mfxuus/music-x-flute/materials/descriptions.docx

5V 10A Power Supply: https://www.amazon.com/dp/B0852HL336

SG90 9G Micro Servo Motor: https://www.amazon.com/dp/B07L2SF3R4

PCA9685 16 Channel 12 Bit PWM Servo Driver: https://www.amazon.com/dp/B014KTSMLA

Caps: https://www.amazon.com/dp/B081XTKCLH

Elastic Band: https://www.amazon.com/dp/B09BQZB98K

Hook and Loop Tape: https://www.amazon.com/dp/B08KP577YY

… along with Raspberry Pi 4 Model B, SD Card, Power Cord for Pi, and connection wires I already had.

Code repo (private repo, for now):

https://github.com/mfxuus/music-x

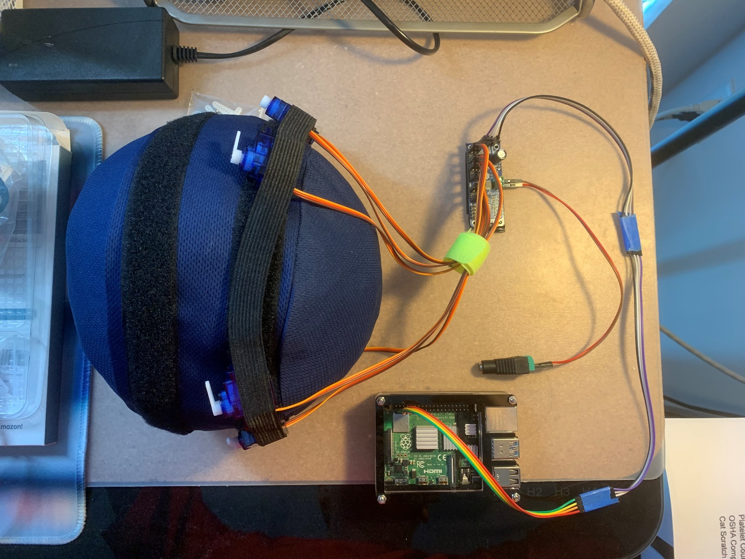
[picture p2: figure]
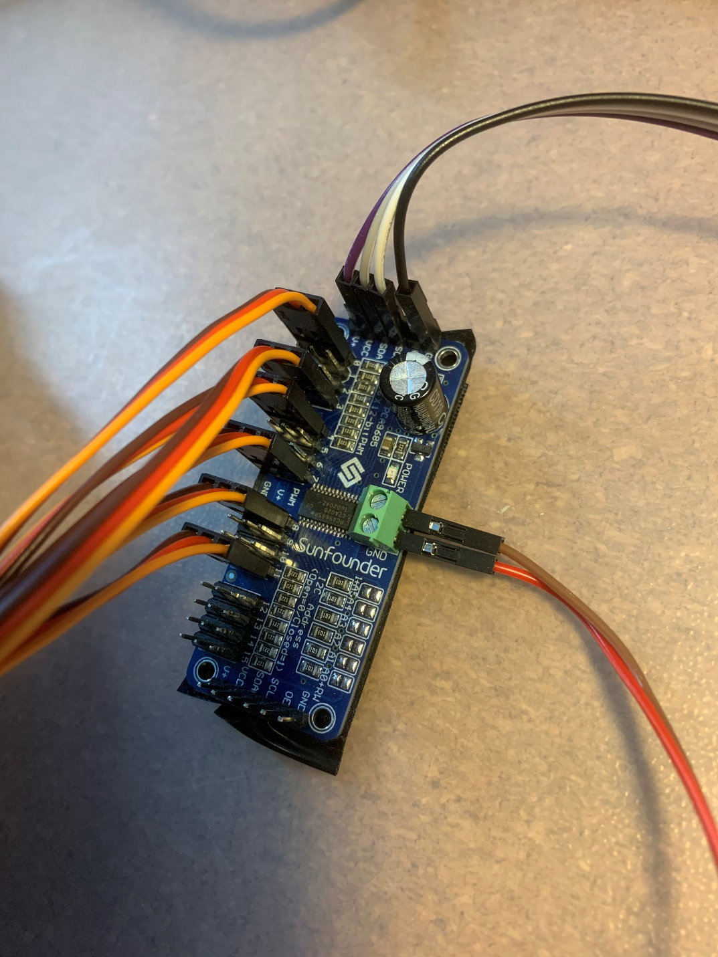
[picture p3: figure]
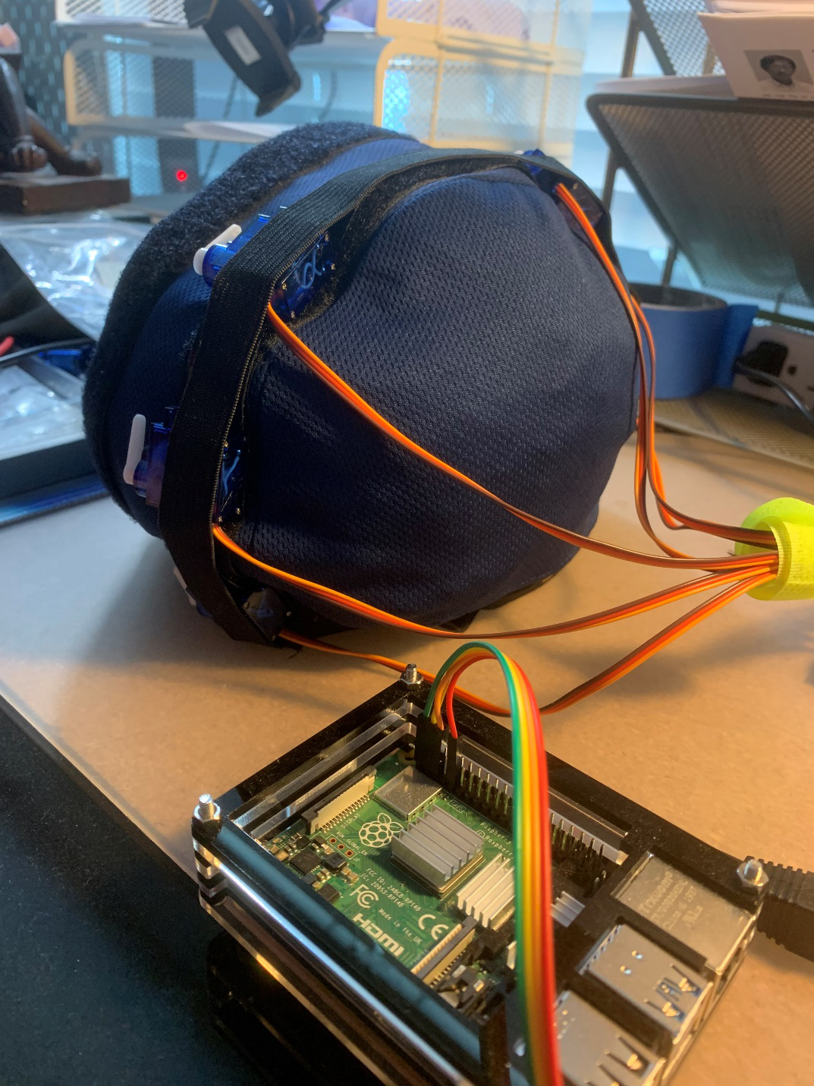
[picture p4: figure]
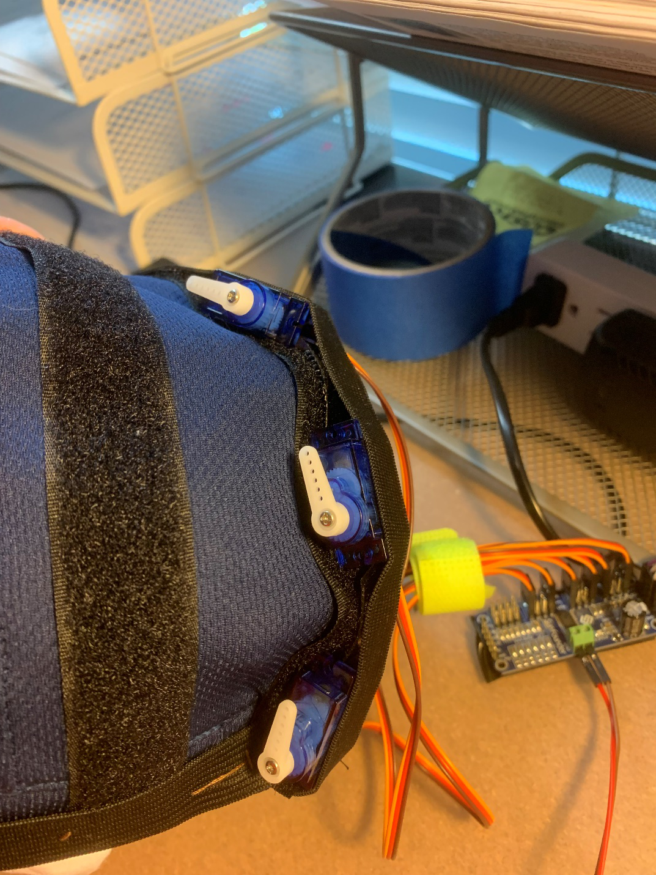
[picture p5: figure]
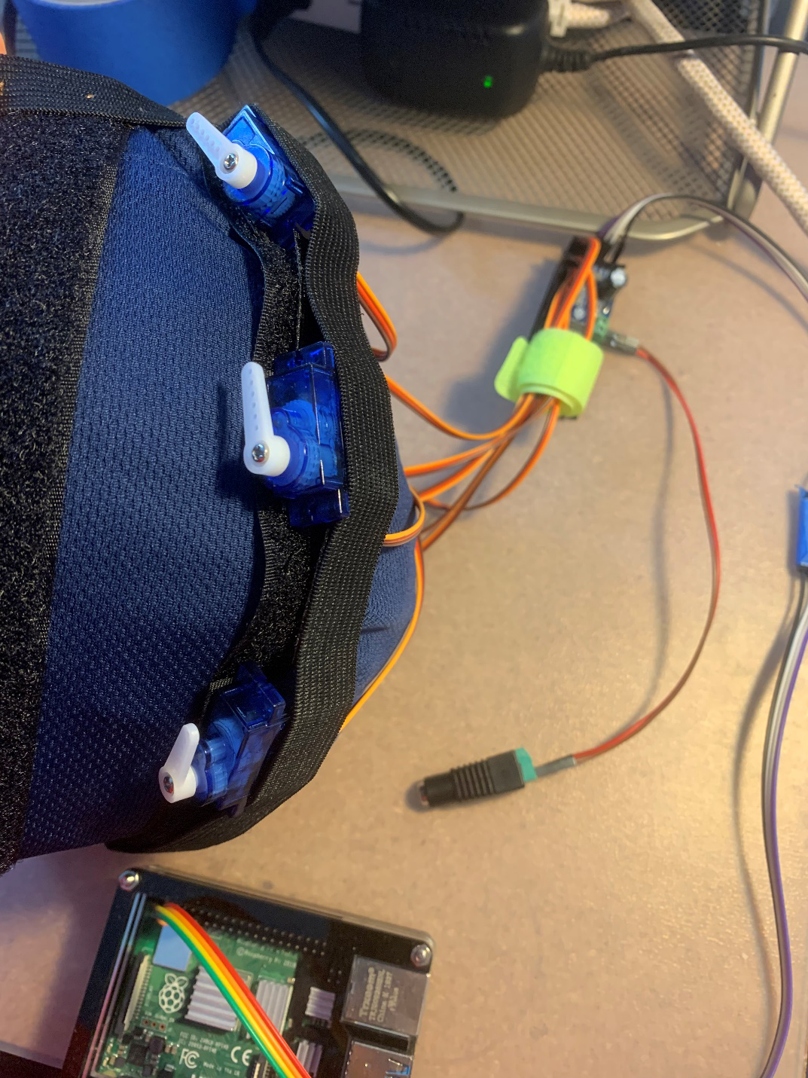
[picture p6: figure]
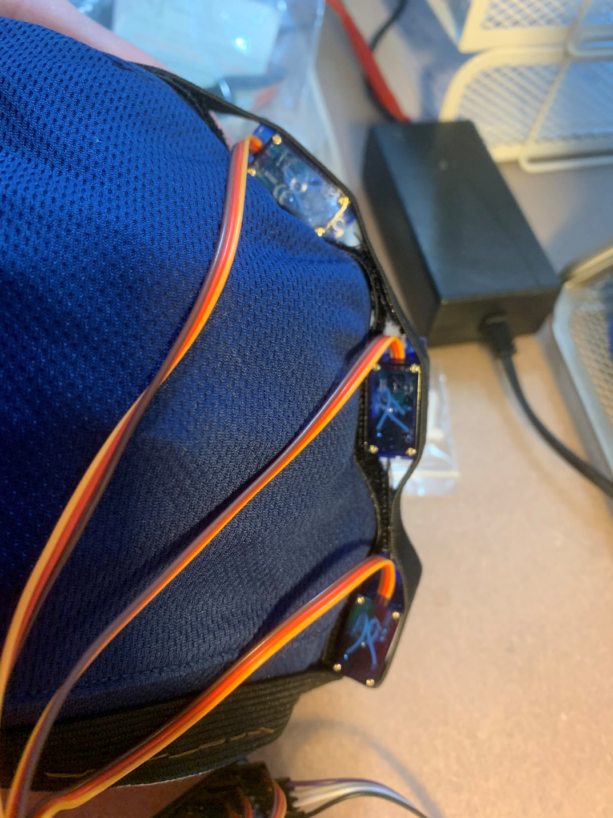
[picture p7: figure]
