mfxuus/music-x-flute/materials/Assembly_Guide.pdf

# Unibody C-Ring Prototype Assembly Guide

Prototype V4.3

- "Body" refers to the flute body part, with six holes, printed by MJF.

o

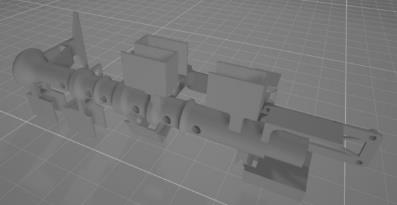
[picture p8: figure]

- In this guide, ordinals start with zero. 0th, 1st, etc.
- Here are the lab-printed parts:
C-Ring × 6 | NanoClip | sensorBox adaptor
sensorBox
grate

sensorBox muter sensorBox
ring
1. Principles:

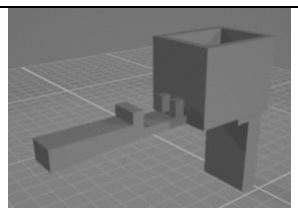
[picture p9: figure]

a. When using hot glue, keep in mind that this is a modular, detachable design. You should be able to remove whatever hot glue there is and replace parts. i.e., don’t much too much hot glue and avoid nooks and crannies.
2. Install a PCA9685 onto Body with nuts and bolts.

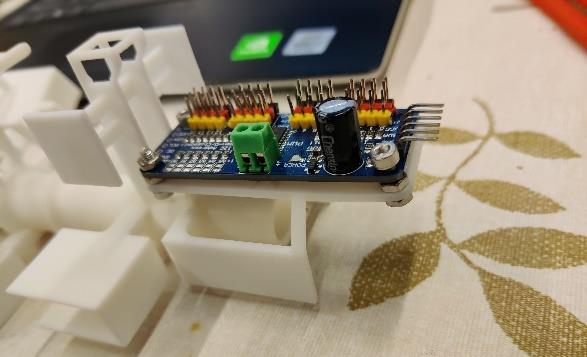
[picture p10: figure]

3. Stick pieces of the bronze tape onto Body.

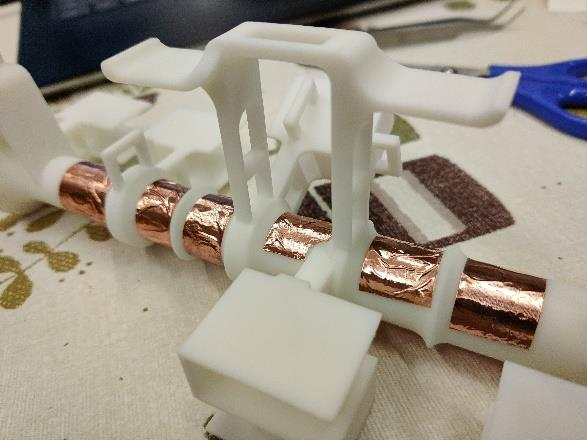
[picture p11: figure]

a. We will call one segment of tape “a tape”.
b. Each tape should enclose both the top (hole area) and the bottom of Body as a “C” shape. The “C” should face against the servo shells, so that you have enough space for tools to move. (It’s ok for a tape to be too long.)

c. Always cut out the left and right borders (making the segment less wide), since these borders are less sticky. (They are usually visibly worn out.)
d. The tapes should not cover areas with too much curvature. In those cases, cut out some tape to avoid edges and curvatures.
e. Press down on every corner of the tapes to ensure contact.
4. Use a box cutter (美工刀) to carve out the holes.

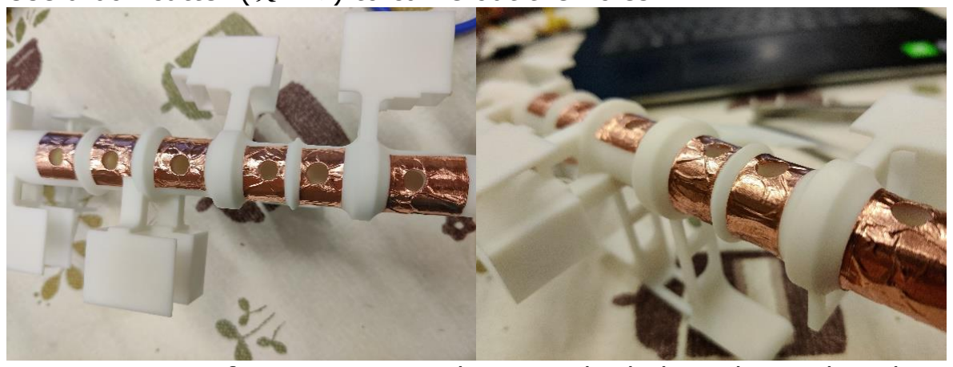
[picture p12: figure]

a. Use your fingers to press down on the holes. This makes the outline of the holes more visible.
b. It’s ok to have some bronze left in the hole. Curve those bronze skirts inward and press them against the inside of the holes. Never cut away too much, otherwise the capacitor sensor may miss the player’s finger.
c. I usually make six cuts forming a hexagon. This makes the process very fast.
5. Did you know? Bronze is bad for your health. Wash your hands NOW!
6. Install an Arduino Nano onto Body with a NanoClip.

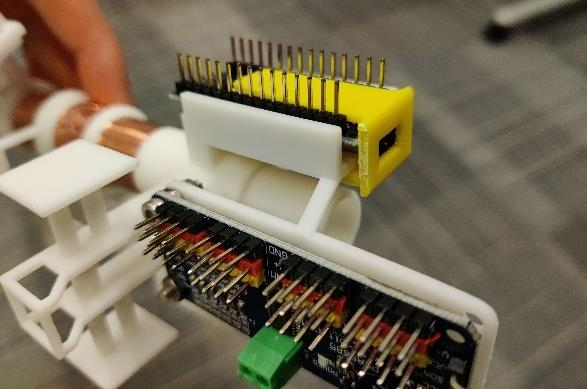
[picture p13: figure]

7. Use six jumper cables to connect the capacitor sensors (i.e., bronze tapes) with the Arduino pin 2, 3, 4, 5, 6, 7. (the 4, 5, 6, 7, 8, 9th pin on Arduino Nano counting from the left on the top row, when Body is placed on its stands.)

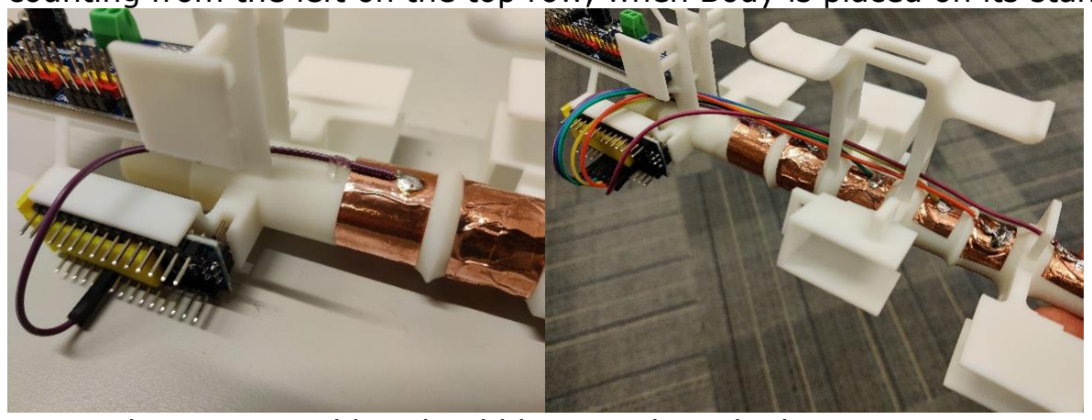
[picture p14: figure]

a. The jumper cables should be Female-Naked.
b. Preferably, color code the cables as red-orange-yellow-green-blue-purple, from the farthest to the closest to the Arduino.

c. Process one cable at a time, one after another, in the sequence: from purple to red. The red and the orange cables need to be longer than 19 cm.
d. For each cable,
i. Attach its Female lead to the Arduino.
ii. Make it go through the hole beneath the flute main cylinder. iii. Cut it at a proper length. The cable heads should easily engage / eject from the pins, but meanwhile there shouldn’t be too much spare length wiggling around.
iv. Take the cable out into the open and expose the copper wires with a wire cutter / scissors. Put it back in again.
v. Solder its Naked lead to the bottom of its corresponding piece of bronze tape. (Pin 2 is the 4th pin on Arduino Nano counting from the left on the top row, when Body is placed on its stands.)
vi. (Do not use hot glue to secure the solder. There won’t be stress on these cables, and hot glue does not attach to bronze well.)
8. Solder four cables onto the BMP085 sensor.

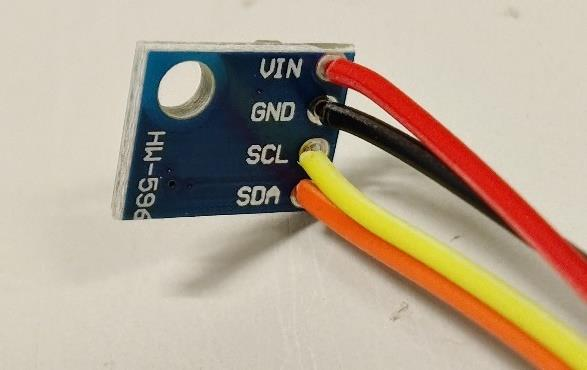
[picture p15: figure]

a. The exposed copper wire should be short, to avoid short circuiting.
b. GND – black – Female.
c. VCC – red – Female.
d. I2C pins (i.e. CLK, DTA).
i. For this, get two M-F jumper cables. Cut each into two parts at arbitrary proportion. Stash the Female parts (let’s call them “Alice”).
ii. Use the two Male parts. CLK – Male. DTA – Male.
9. Put the BMP085 sensor into the sensorBox adaptor
a. Use a nut and a bolt to secure the sensor into the adaptor. Do not apply too much stress.

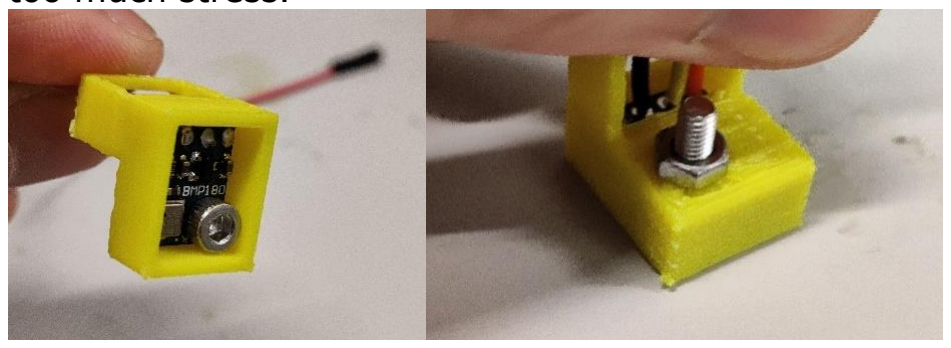
[picture p16: figure]

b. Use hot glue to secure the cables onto the extended cable ring on the adaptor. Secure both sides.

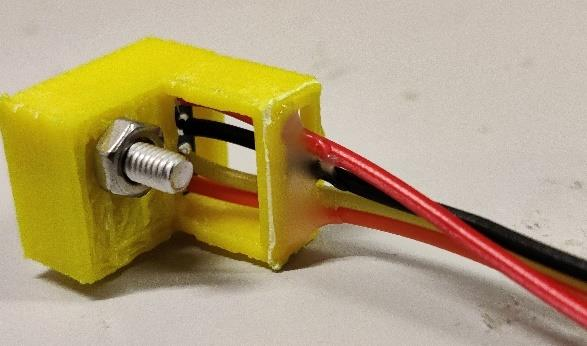
[picture p17: figure]

10.Make two 3-junctions.

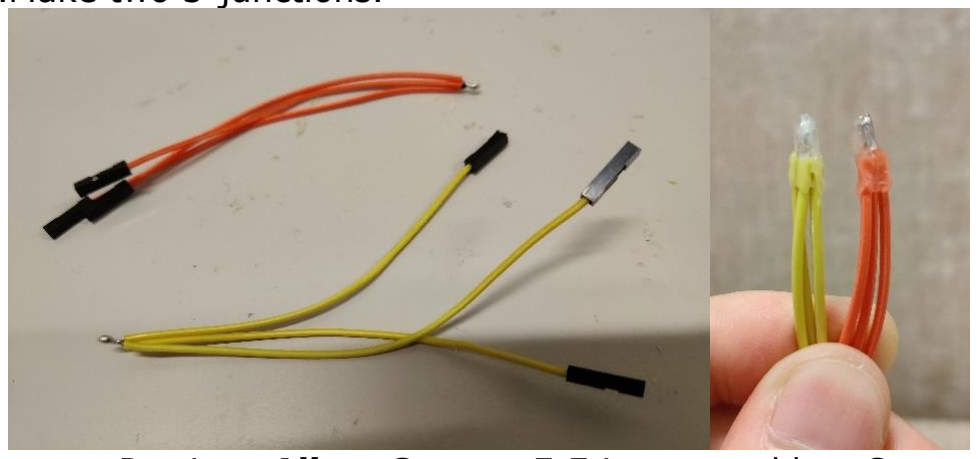
[picture p18: figure]

a. Retrieve Alice. Get two F-F jumper cables. Cut each F-F cable into two halves.
b. Solder three half-cables together to get a F-F-F 3-junction.
c. Use hot glue to cover the exposed wires.
11.Apply the 3-junctions.
a. CLK: Arduino A5 – PCA9685 – floated.
b. SDA: Arduino A4 – PCA9685 – floated.
c. (Pin A5, A4 is the 6th, 7th pin on Arduino Nano counting from the left on the bottom row, when Body is placed on its stands.)
12.Initialize HC-05.

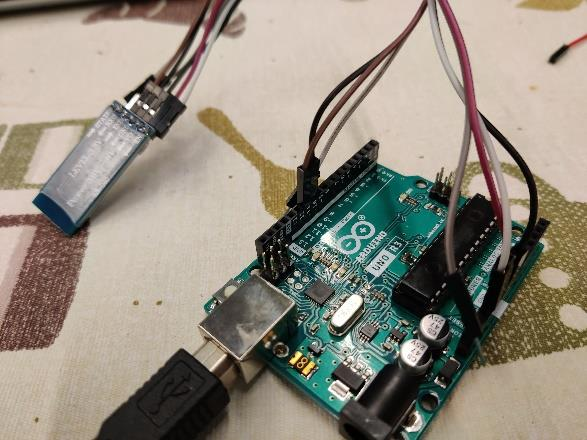
[picture p19: figure]

a. Optionally, get a spare Arduino Uno / Mega.
b. Open “MAIN/ardu/setupBluetooth” Arduino script.
c. Connect pin 10 with TXD, pin 11 with RXD, 5V with VCC, GND with GND, and 3V3 with EN.
d. Make sure the constant `MODE` is `1` and upload the script. Then, open Serial Monitor. Read everything – make sure the assertions are true. If everything checks out and the last line says “Arduino script exits”, we are good.
e. Retrieve HC-05 from this circuit.

13.Install the HC-05 module onto Body with clear tape.

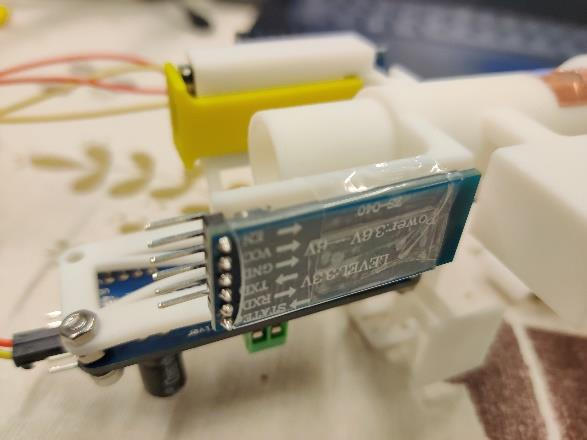
[picture p20: figure]

14.Assemble the sensorBox.
a. Put the grates into the muter.

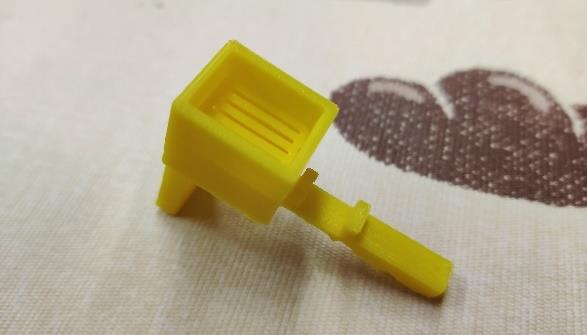
[picture p21: figure]

b. Add water absorbing beads into the muter chamber.

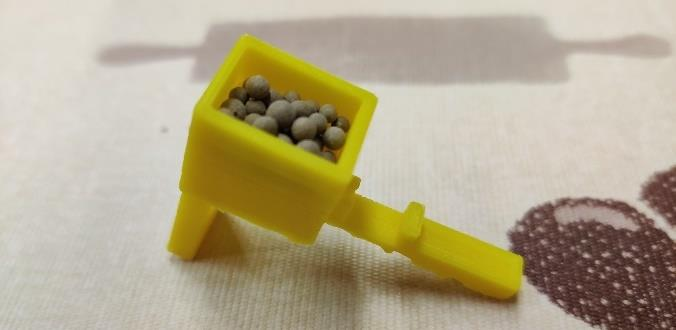
[picture p22: figure]

i. They must fill the entire 2D cross section.
c. Use clear tape to join the muter with the adaptor.

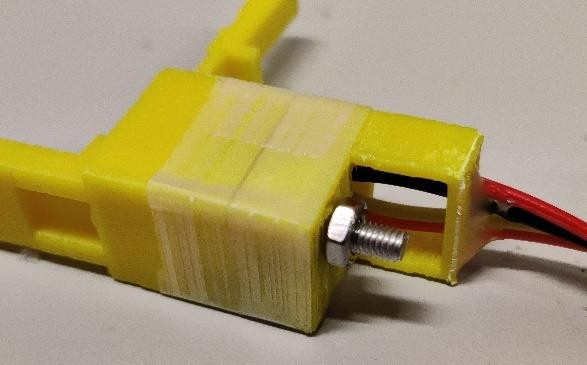
[picture p23: figure]

i. It must be air-tight, otherwise the air pressure will be invalid. ii. However, avoid the air hole on the side of the muter.

15.Hot-glue the servo wings into the wing-shaped holes on the C-Rings.

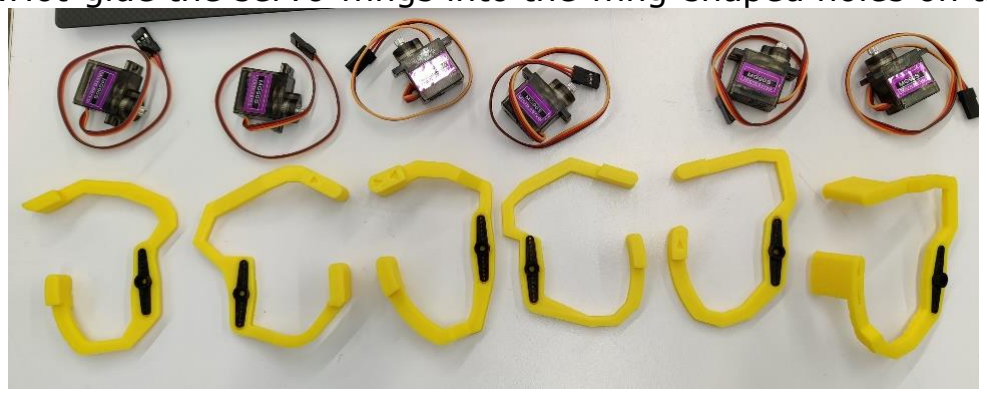
[picture p24: figure]

a. Be careful not to tilt the servo wing. They should lay flat – pressing them down in their center helps.
b. Usually, the way they come off is via the hot glue losing contact with the C-Ring, so make sure the hot glue covers enough area on the C-Ring as shown below:

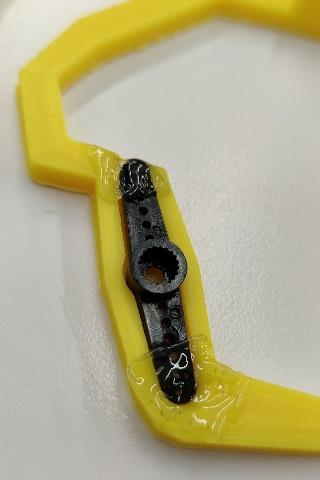
[picture p25: figure]

c. However, also keep the hot glue flat – too much bump may collide with adjacent C-Rings.
16.Insert the servos into Body.
a. Sequence: right ring, middle, index, left ring, middle, and index finger. They should connect to servo pins 15, 14, 13, 12, 11, and 10 on the Arduino Nano. Differentiate the left middle finger and the left ring finger!
b. For each servo, first make the servo cables go through the cable ring of the servo shell.

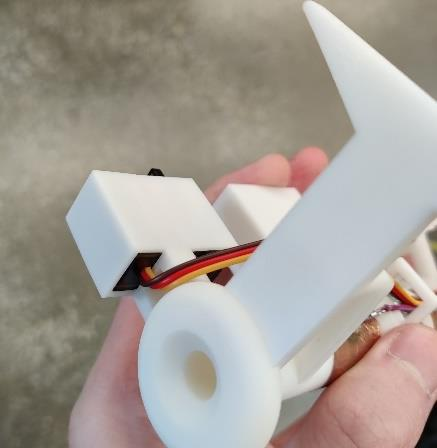
[picture p26: figure]

c. Use cable rings under Body as much you can. This prevents cables’ collision with C-Rings.

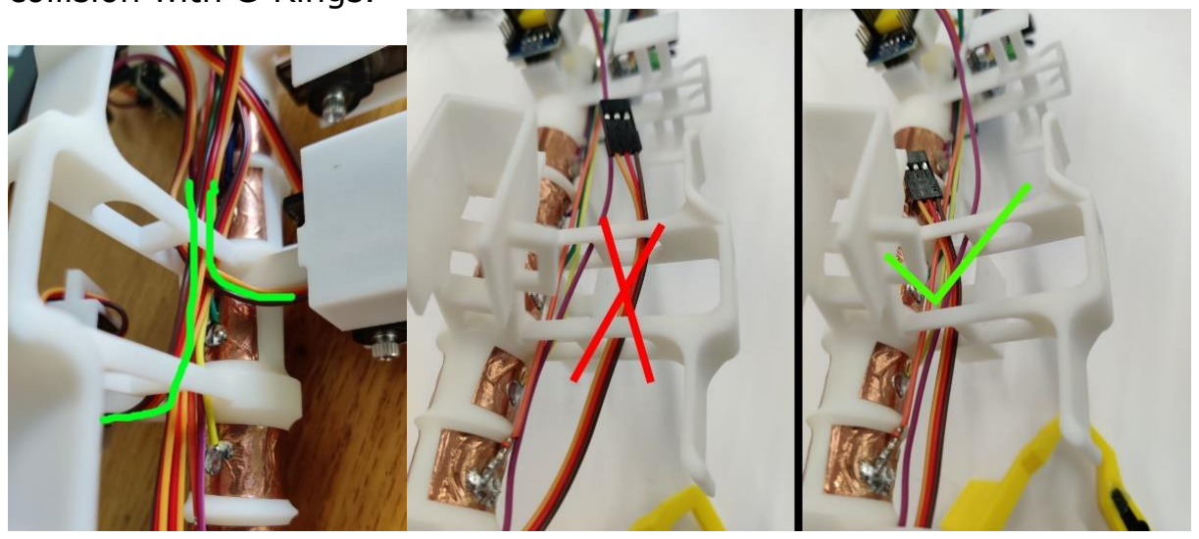
[picture p27: figure]

d. For the right index finger’s servo, there are two extra servo rings. Go through the side one, and then the bottom one, and then both thumb stands. This prevents collision with the left ring finger’s C-Ring.

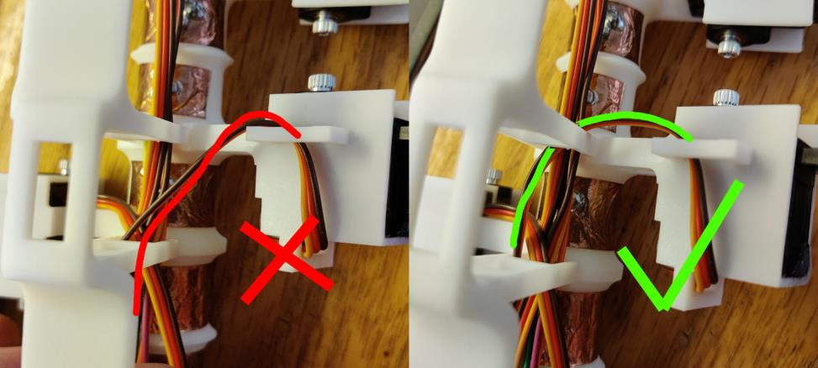
[picture p28: figure]

e. Use the cable coil on Body to use up extra cable length. Purpose: not to have cable loops dangling around.

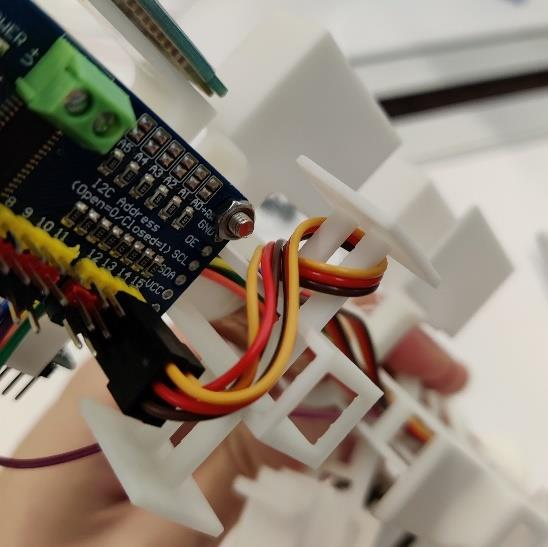
[picture p29: figure]

i. Tips for wrapping cables around the cable coil: if wrapping one way (e.g. clockwise) turns our to leave 0.5 cycle unpreferred, try unwinding wrapping the other way (e.g. counter-clockwise). This solves the 0.5-cycle phase problem.

f. Make sure to leave enough space for the battery:

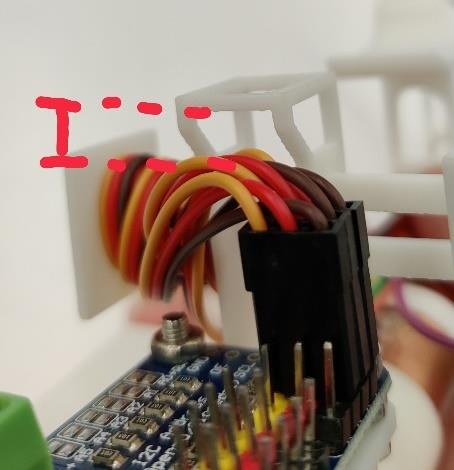
[picture p30: figure]

g. Use little hot glue to secure the servos.

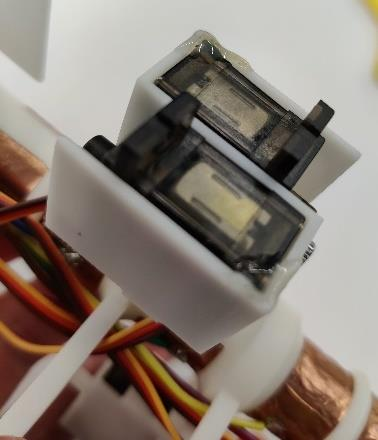
[picture p31: figure]

17.Install battery and switch.
a. Get a short, thick piece of solid-wire cable. Expose its wire at both ends. At one end, curl it like this for maximal contact with PCA9685:

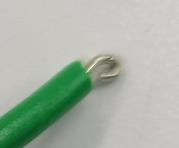
[picture p32: figure]

b. Solder its other end onto the middle pin of the switch.

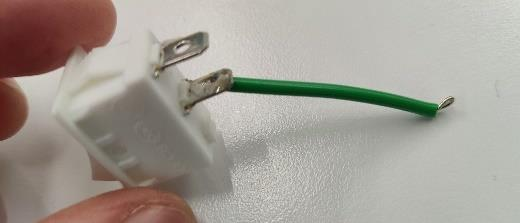
[picture p33: figure]

c. Strip the battery’s discharge cable. Be really careful! The inner wires are thin. Don’t impose any dents – 5V2A is suppose to go through them!
d. Get another short, thick piece of solid-wire cable. Curl one end like before. Solder it onto the GND of battery discharge.

e. Solder the VCC of battery discharge to the switch.

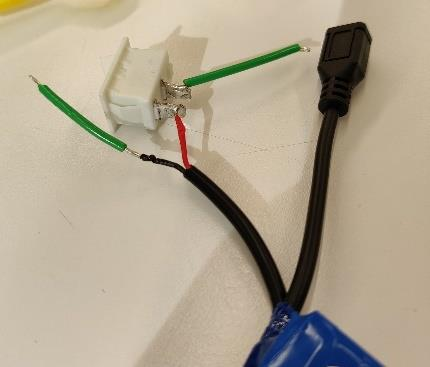
[picture p34: figure]

f. Solder is bad for your health. Wash your hands.
g. Use duct tape (or cleat tape as shown in the photos) to strap the battery onto Body.
i. Use tape to form an X in this part of Body.

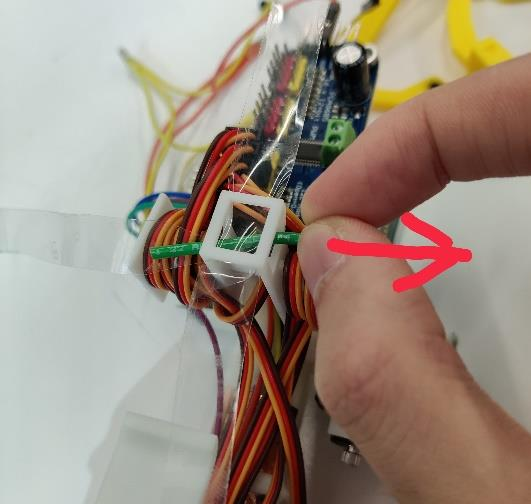
[picture p35: figure]

ii. Use a solid object (e.g. green wire, as shown in photo above) to lead the tape. Both pieces of tape should have their sticky side facing upwards (i.e. away from PCA9685). However, when inserting the second piece of tape, first face the sticky side downward (to avoid sticking to the other piece of tape), and then turn it 180°.
iii. The X should look like this.

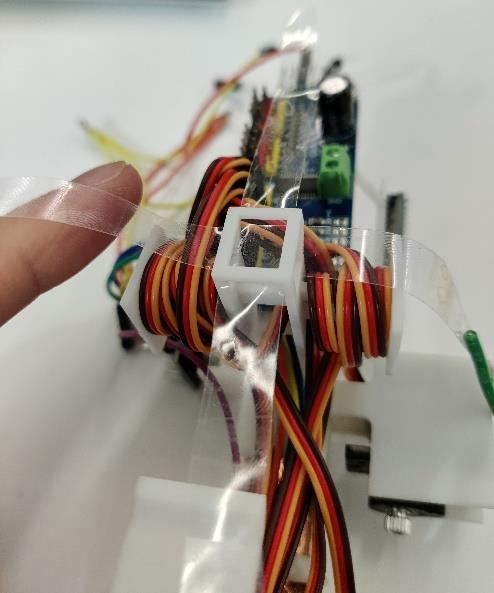
[picture p36: figure]

iv. Use the cross to strap the battery in place. The vertical space above the power supply terminal block of PCA9685 should be clear (so that a screwdriver won’t be blocked).

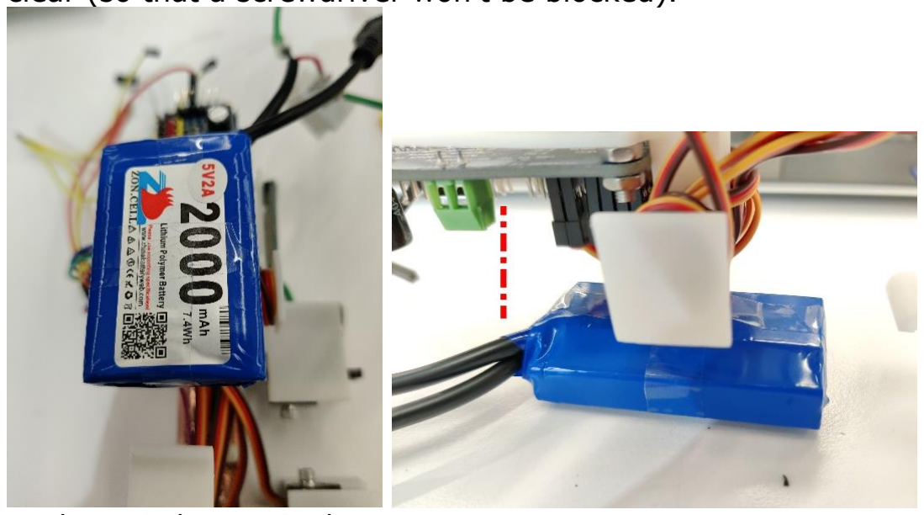
[picture p37: figure]

h. Hot-glue the switch onto Body.

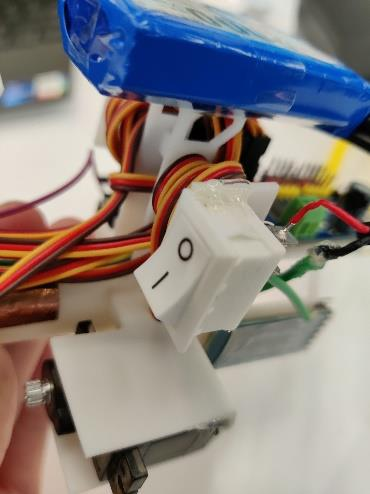
[picture p38: figure]

i. Insert the curled ends into PCA9685 power supply (i.e., terminal block). Make sure VCC - V+, and GND - GND. Use a screwdriver to secure the PCA9685 power supply, tightly.

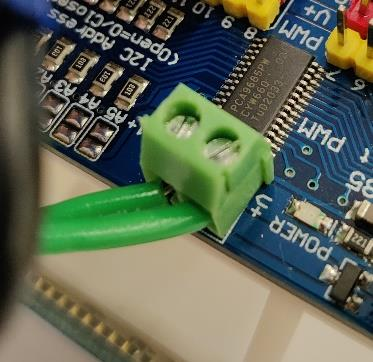
[picture p39: figure]

18.Use two 轧带 to constrain the cables. One above left index finger (i.e., first hole) and one below right ring finger (i.e., last hole).

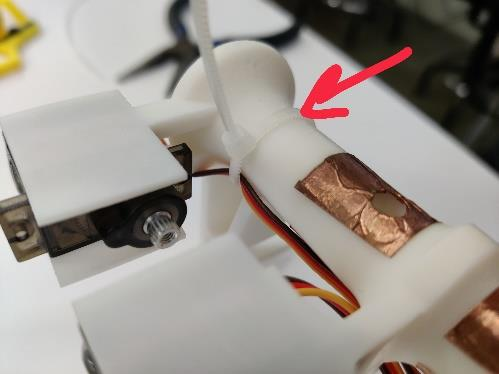
[picture p40: figure]

a. Cut away the extra strip. Then, rotate the strip until the cables snap into the 90-degree corner of the 轧带.

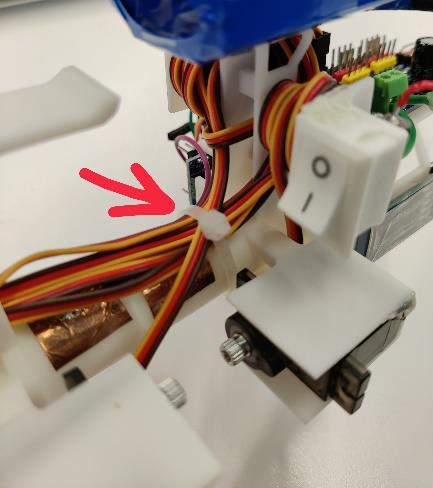
[picture p41: figure]

b. Applied a tiny bit of hot glue to the one above left index finger to prevent sliding.

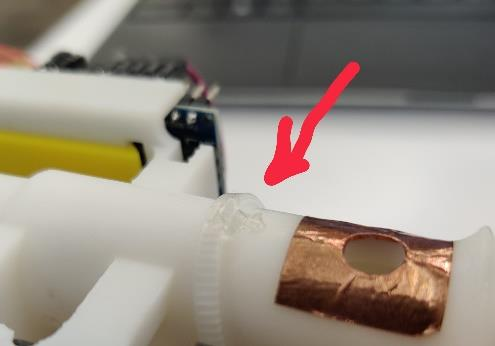
[picture p42: figure]

19.Finish cable connections.
a. F-F 10cm: PCA9685 GND in – PCA9685 GND out.
i. “PCA9685 GND in” is one of the six pins on the side. “PCA9685 GND out” refers to one of the black pins for servos.
b. F-F 10cm: PCA9685 VCC in – PCA9685 5V out.
i. “PCA9685 VCC in” is one of the six pins on the side. “PCA9685 5V out” refers to one of the red pins for servos.
ii. Maybe make a knot to further shrink the cable length.

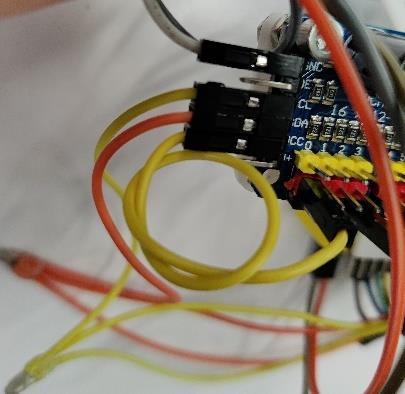
[picture p43: figure]

c. F-F 10cm: Arduino Nano GND – PCA9685 GND out.
i. Nano GND pin is the 1

st from the left, in the lower row.
d. F-F 10cm: Arduino Nano 5V – PCA9685 5V out.
i. Nano 5V pin is the 3rd from the left, in the lower row.
e. F-F 20cm: Arduino Nano pin TX1 – HC05 RX.
i. Nano pin TX1 is the 0

st from the left, in the upper row. ii. The cable should go below Body and PCA9685 – curve all the way around.
f. F-F 20cm: Arduino Nano pin RX0 – HC05 TX.
i. Nano pin RX0 is the 1

st from the left, in the upper row.

ii. The cable should go below Body and PCA9685 – curve all the way around.
g. F-F 10cm: HC05 GND – PCA9685 GND out.
h. F-F 10cm: HC05 VCC – PCA9685 5V out.
20.Upload the Arduino script (“MAIN/ardu/ardu.ino”) to Arduino Nano. Then, disconnect the USB.
21.Recharge the battery. Follow the manual in order not to overcharge or undercharge it. After charging, disconnect the charging cable.
22.Apply sensorBox ring onto the mouthpiece. Insert the mouthpiece into Body. Insert the sensorBox into the mouthpiece. Rotate sensorBox ring to secure sensorBox.

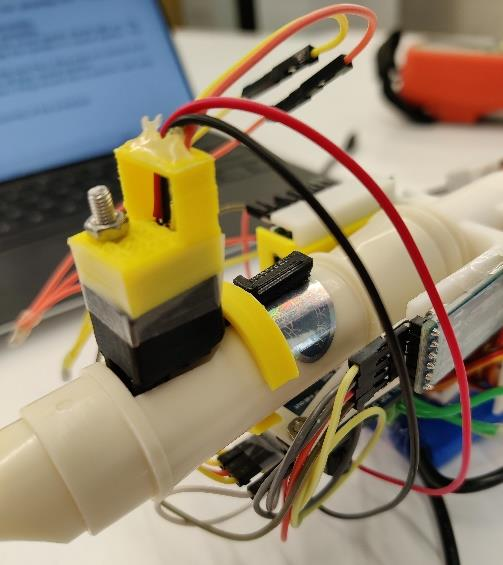
[picture p44: figure]

23.Connect sensorBox GND – PCA9685 GND out; sensorBox VCC – PCA9685 5V out; finally, 3-junction:
a. CLK: Arduino A5 (–) PCA9685 – sensorBox.
b. SDA: Arduino A4 (–) PCA9685 – sensorBox.
24.Flip the switch on! The LEDs on all three circuit boards should light up. The servos should make a sound and rotate the cylinders to neutral position. Flip the switch off.
25.Attach the C-Rings to the servos. Make sure the C-Ring ends are almost level, without rotating the servo cylinders off their neutral position.
26.Flip the switch on. Double check: the C-Rings should stay in position, with ends leveled. Flip the switch off.

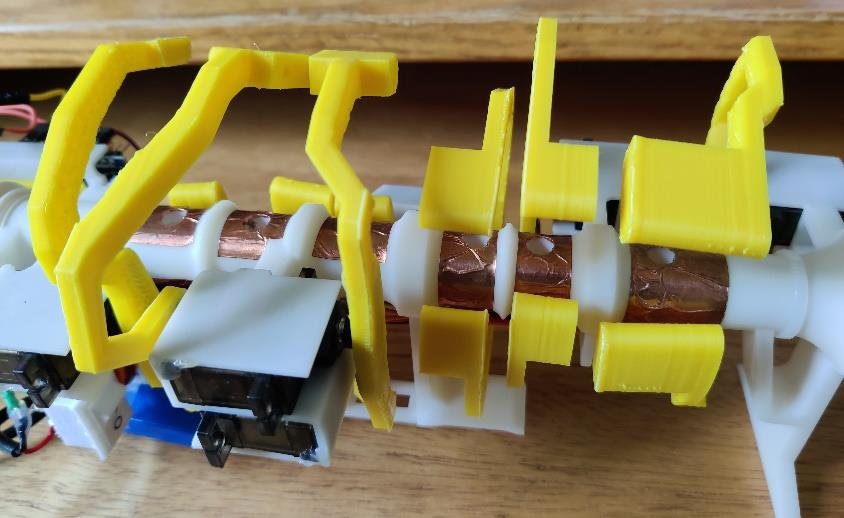
[picture p45: figure]

Congratulations. You completed the assembly of the prototype.

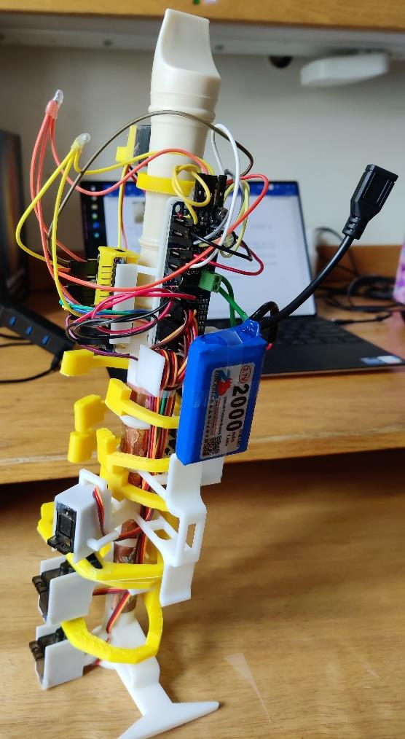
[picture p46: figure]
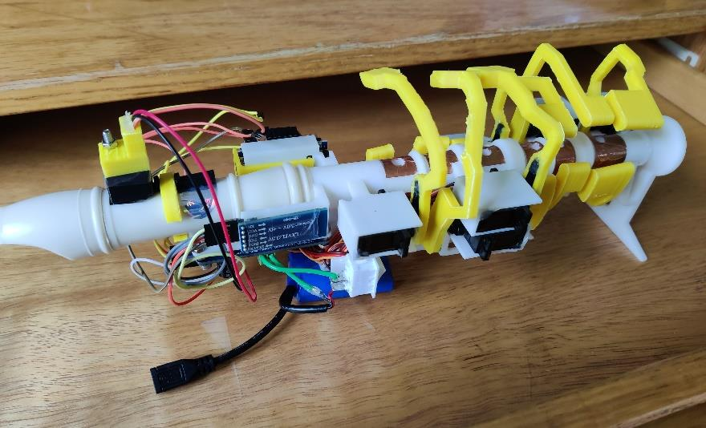
[picture p47: figure]
