mfxuus/music-x-flute/test logs/test_notes_4.PNG

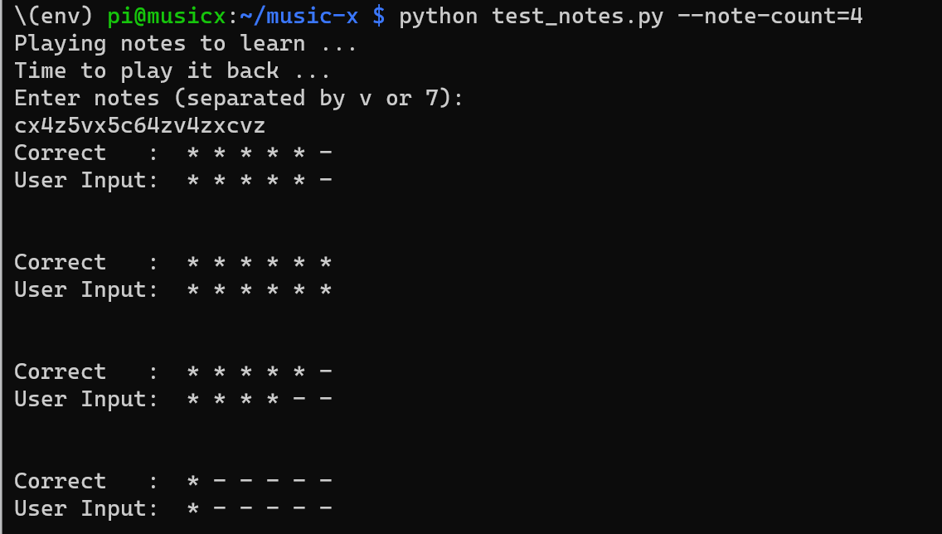
test logs/test_notes_4.PNG
