mfxuus/music-x-flute/test logs/test_notes_6.PNG

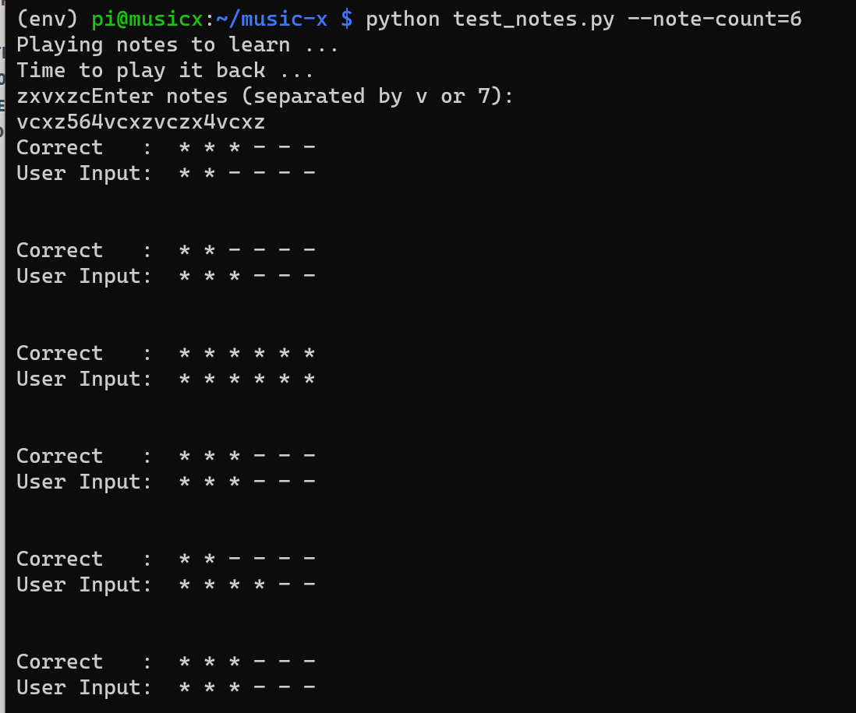
test logs/test_notes_6.PNG
