mfxuus/music-x-flute/UI/server/notes_to_learn.py

phase_1_notes = [
    [2, 5, 5, 7, 5, 5],
    [7, 9, 7, 9, 0, 2],
    [9, 7, 9, 7, 9, 0],
    [5, 9, 9, 5, 2, 2],
    [0, 2, 5, 2, 0, 2],
    [7, 0, 4, 5, 7, 7],
    [0, 9, 0, 2, 2, 2],
    [5, 2, 4, 2, 0, 11],
    [4, 0, 0, 7, 2, 0],
    [4, 0, 5, 7, 9, 5],
    [7, 9, 0, 2, 0, 9],
    [7, 4, 2, 4, 4, 5],
    [2, 2, 4, 2, 0, 9],
    [2, 7, 7, 7, 4, 0],
    [9, 9, 0, 11, 2, 0],
    [2, 0, 4, 4, 2, 11],
    [0, 7, 2, 0, 11, 0],
    [0, 2, 0, 2, 7, 0],
    [5, 0, 11, 7, 9, 4],
    [4, 5, 0, 4, 2, 11]
]

phase_2_notes = [
    [9, 9, 0, 0, 9, 2],
    [4, 2, 0, 2, 7, 9],
    [0, 2, 2, 0, 2, 7],
    [7, 5, 5, 5, 4, 2],
    [4, 0, 2, 0, 9, 5],
    [4, 0, 2, 4, 5, 2],
    [2, 2, 9, 2, 0, 11],
    [5, 4, 2, 0, 2, 2],
    [9, 0, 4, 9, 0, 9],
    [5, 9, 7, 0, 5, 5],
    [4, 7, 9, 4, 0, 2],
    [0, 11, 9, 11, 0, 4],
    [0, 2, 4, 4, 4, 2],
    [5, 4, 2, 0, 9, 0],
    [0, 11, 0, 11, 0, 11],
    [9, 4, 7, 9, 7, 9],
    [4, 2, 0, 9, 2, 0],
    [4, 2, 4, 4, 4, 4],
    [2, 2, 4, 4, 2, 0],
    [9, 4, 2, 0, 2, 7]
]

phase_3_notes = [
    [4, 2, 11, 11, 7, 9],
    [7, 7, 4, 0, 2, 9],
    [2, 4, 4, 2, 0, 2],
    [9, 7, 0, 2, 0, 9],
    [2, 4, 9, 2, 4, 7],
    [0, 2, 4, 2, 4, 2],
    [7, 9, 7, 4, 7, 9],
    [4, 11, 0, 2, 0, 11],
    [4, 2, 0, 0, 7, 4],
    [2, 11, 9, 7, 9, 9],
    [9, 0, 11, 11, 0, 4],
    [9, 7, 7, 0, 9, 2],
    [5, 7, 5, 7, 9, 0],
    [0, 9, 11, 0, 4, 2],
    [0, 7, 5, 4, 0, 2],
    [5, 5, 5, 4, 2, 2],
    [5, 7, 9, 0, 0, 5],
    [2, 0, 4, 7, 7, 4],
    [2, 0, 2, 5, 2, 0],
    [4, 2, 0, 9, 0, 4]
]
